clairbee/rebot-devarm/hardware/reBot_B601_RS/gripper.md

# gripper

The B601 RS gripper as the released assembly holds it (22 of its 23 components; 2-M7-STATOR.step is not published)

Package: `//pub/robotics/rebot/devarm/b601-rs`

gripper

## Parts

### [//pub/robotics/rebot/devarm/b601-rs](README.md)

| Part |  | Count | Material | Method | Process | Tolerance | Vendor | SKU | File | Description |
| --- | --- | ---: | --- | --- | --- | ---: | --- | --- | --- | --- |
| actuator-rs00 | actuator-rs00 | 1 | aluminium alloy |  |  |  | seeedstudio | [Robostride-00-Actuator-p-6664](https://www.seeedstudio.com/Robostride-00-Actuator-p-6664.html) | `vendor/actuator-rs00.step` | Brushless actuator RobStride RS00 (x4) |
| carriage-mgn9 | carriage-mgn9 | 2 | stainless steel |  |  |  | amazon | B0D9QBQDKB | `vendor/carriage-mgn9c.step` | Slider block MGN9 (x2, gripper) |
| connector-xt30 | connector-xt30 | 2 | nylon |  |  |  |  |  | `vendor/connector-xt30-2x2.step` | XT30 2+2 connector body, the motor end of a harness (x12 in the released CAD) |
| finger | finger | 2 | ABS | additive |  | ±0.2 mm |  |  | `3D_Printed_Parts/1-CLIP.step` | Gripper finger (x2) - print from the side of the gripper for strength; 0.4 mm nozzle, 0.2 mm layer height, 45% infill |
| gear-connector | gear-connector | 1 | AL 5052 | subtractive | Anodized or sandblasted, H7 or interference fit on mating features | ±0.02 mm |  |  | `Metal_Parts/02_Gear_Connector.step` | The boss the gripper pinion sits on (x1) - RS copy: 2-M7-ROTOR.step, which README.md calls 2-M7-STATOR.step and lists as "gripper connector B" |
| gear-m1-16t | gear-m1-16t | 1 | steel |  |  |  | amazon | B0GDSR1LKM | `vendor/gear-m1-16t-b6.step` | Module 1, 16 tooth, 6 mm bore gear - what drives the two gripper racks (x1) |
| gripper-connector-a | gripper-connector-a | 1 | AL 5052 | subtractive | Anodized or sandblasted, H7 or interference fit on mating features | ±0.02 mm |  |  | `Metal_Parts/02_Gripper_Connector_A.step` | Gripper connector A (x1) - RS copy: 2-M6-ROTOR.step |
| motor-cable-clip | motor-cable-clip | 1 | AL 5052 | subtractive | Anodized or sandblasted, H7 or interference fit on mating features | ±0.02 mm |  |  | `Metal_Parts/1-O-CLIP.step` | Motor 4-7 cable fixing (x4) - can be printed in ABS with M2 nuts instead |
| pad-silicone | pad-silicone | 4 | silicone |  |  |  | amazon | B0F9KVYXFZ | `vendor/pad-silicone-30x9x2.step` | Silicone pad 30x9x2mm (x1 per the readme; the released CAD has four) |
| rack | rack | 2 | AL 5052 | subtractive | Anodized or sandblasted, H7 or interference fit on mating features | ±0.02 mm |  |  | `Metal_Parts/02_Rack.step` | Rack (x2) - RS copy: 2-RACK-1M.step |
| rail-bracket | rail-bracket | 1 | PLA | additive |  | ±0.2 mm |  |  | `3D_Printed_Parts/01_Rail_Bracket.step` | Gripper slider support bracket (x1) - RS copy: 1-RAIL-BASE-2.step |
| rail-mgn9-170 | rail-mgn9-170 | 1 | stainless steel |  |  |  | amazon | B0D54L45WM | `vendor/rail-mgn9-170.step` | Linear rail MGN9-170mm (x1, gripper) |
| slider-bracket | slider-bracket | 1 | AL 5052 | subtractive | Anodized or sandblasted, H7 or interference fit on mating features | ±0.02 mm |  |  | `Metal_Parts/02_Slider_Bracket.step` | Gripper slider metal bracket (x1) - RS copy: 2-RAIL-BASE-1.step |
| slider-extension | slider-extension | 2 | AL 5052 | subtractive | Anodized or sandblasted, H7 or interference fit on mating features | ±0.02 mm |  |  | `Metal_Parts/02_Slider_Extension.step` | Slider to gripper extension (x2) - RS copy: 2-SLIDER-FIX.step |

## Stock

What the manufactured parts are made from: one piece for each part made from it.

### [//pub/robotics/rebot/devarm/b601-rs](README.md)

| Stock | Count | For | Description |
| --- | ---: | --- | --- |
| gear-connector-blank | 1 | gear-connector |  |
| gripper-connector-a-blank | 1 | gripper-connector-a | The 5052 plate gripper-connector-a is cut from |
| motor-cable-clip-blank | 1 | motor-cable-clip | The 5052 plate motor-cable-clip is cut from |
| rack-blank | 2 | rack | The 5052 plate rack is cut from |
| slider-bracket-blank | 1 | slider-bracket | The 5052 plate slider-bracket is cut from |
| slider-extension-blank | 2 | slider-extension | The 5052 plate slider-extension is cut from |

<br/><br/>

*Generated by [PartCAD](https://partcad.org/)*
