clairbee/rebot-devarm/hardware/reBot_B601_DM/gripper.md

# gripper

The B601 DM gripper as the released assembly holds it (49 components)

Package: `//pub/robotics/rebot/devarm/b601-dm`

gripper

## Parts

### [//pub/robotics/rebot/devarm/b601-dm](README.md)

| Part |  | Count | Material | Method | Process | Tolerance | Vendor | SKU | File | Description |
| --- | --- | ---: | --- | --- | --- | ---: | --- | --- | --- | --- |
| carriage-mgn9 | carriage-mgn9 | 2 | stainless steel |  |  |  | amazon | B0D9QBQDKB | `vendor/carriage-mgn9c.step` | Slider block MGN9 (x2, gripper) |
| finger | finger | 2 | ABS | additive |  | ±0.2 mm |  |  | `3D_Printed_Parts/01_Finger.step` | Gripper finger (x2); 0.4 mm nozzle, 0.2 mm layer height, 45% infill |
| gear-connector | gear-connector | 1 | AL 5052 | subtractive | Anodized or sandblasted, H7 or interference fit on mating features | ±0.02 mm |  |  | `Metal_Parts/02_Gear_Connector.step` | Gear connector (x1) |
| gear-m1-16t | gear-m1-16t | 1 | steel |  |  |  | amazon | B0GDSR1LKM | `vendor/gear-m1-16t-b6.step` | Module 1, 16 tooth, 6 mm bore gear - what drives the two gripper racks (x1) |
| rack | rack | 2 | AL 5052 | subtractive | Anodized or sandblasted, H7 or interference fit on mating features | ±0.02 mm |  |  | `Metal_Parts/02_Rack.step` | Rack (x2) |
| rail-bracket | rail-bracket | 1 | PLA | additive |  | ±0.2 mm |  |  | `3D_Printed_Parts/01_Rail_Bracket.step` | Gripper slider support bracket (x1); 0.4 mm nozzle, 0.2 mm layer height, 15% infill |
| rail-mgn9-170 | rail-mgn9-170 | 1 | stainless steel |  |  |  | amazon | B0D54L45WM | `vendor/rail-mgn9-170.step` | Linear rail MGN9-170mm (x1, gripper) |
| screw-hm3-25 | screw-hm3-25 | 6 | stainless steel |  |  |  | amazon | B0DJQFGRPQ (120 per pack) | `vendor/screw-hm3x25.step` | M3x25 hex socket head cap screw (x14+) |
| screw-hm3-6 | screw-hm3-6 | 4 | stainless steel |  |  |  | amazon | B0DJQG5YLF (120 per pack) | `vendor/screw-hm3x6.step` | M3x6 hex socket head cap screw (x16+) |
| screw-ka3-12 | screw-ka3-12 | 4 | steel |  |  |  | amazon | B01MXSS95N (100 per pack) | `vendor/screw-ka3x12.step` | KA3x12 self-tapping screw (x60; README.md says 72+) |
| screw-km3-16 | screw-km3-16 | 8 | stainless steel |  |  |  | amazon | B01E6EIC2S | `vendor/screw-km3x16.step` | M3x16 countersunk head screw (x34+) |
| screw-km3-7 | screw-km3-7 | 12 | stainless steel |  |  |  | amazon | B01E6EIC2S | `vendor/screw-km3x7.step` | M3x7 countersunk head screw (x76+) |
| screw-m4x5-set | screw-m4x5-set | 2 | steel |  |  |  |  |  | `vendor/screw-m4x5-set.step` | M4x5 set screw (x2); the released CAD calls it S-M4-5-JIMI and README.md does not list it |
| slider-bracket | slider-bracket | 1 | AL 5052 | subtractive | Anodized or sandblasted, H7 or interference fit on mating features | ±0.02 mm |  |  | `Metal_Parts/02_Slider_Bracket.step` | Gripper slider metal bracket (x1) - printable in ABS at high infill, not for long-term use |
| slider-extension | slider-extension | 2 | AL 5052 | subtractive | Anodized or sandblasted, H7 or interference fit on mating features | ±0.02 mm |  |  | `Metal_Parts/02_Slider_Extension.step` | Slider to gripper extension (x2) |

## Stock

What the manufactured parts are made from: one piece for each part made from it.

### [//pub/robotics/rebot/devarm/b601-dm](README.md)

| Stock | Count | For | Description |
| --- | ---: | --- | --- |
| gear-connector-blank | 1 | gear-connector | The 5052 plate gear-connector is cut from |
| rack-blank | 2 | rack | The 5052 plate rack is cut from |
| slider-bracket-blank | 1 | slider-bracket | The 5052 plate slider-bracket is cut from |
| slider-extension-blank | 2 | slider-extension | The 5052 plate slider-extension is cut from |

<br/><br/>

*Generated by [PartCAD](https://partcad.org/)*
