clairbee/rebot-devarm/hardware/reBot_B601_DM/power-supply.md

# power-supply

Power supply enclosure, assembled per README.md "Power Supply Assembly"

Package: `//pub/robotics/rebot/devarm/b601-dm`

power-supply

## Parts

### [//pub/robotics/rebot/devarm/b601-dm](README.md)

| Part |  | Count | Material | Method | Tolerance | Vendor | SKU | File | Description |
| --- | --- | ---: | --- | --- | ---: | --- | --- | --- | --- |
| connector-xt60e | connector-xt60e | 1 | nylon |  |  | amazon | B0CQK1P1DP | `src/connector_xt60e.py` | Output port XT60E female + lug pigtail (x1) |
| psu-front-cover | psu-front-cover | 1 | PLA | additive | ±0.2 mm |  |  | `3D_Printed_Parts/DM-power-Top Cover.stp` | Power supply front cover (x1); 0.4 mm nozzle, 0.2 mm layer height, 30% infill |
| psu-front-cover-slider | psu-front-cover-slider | 1 | PLA | additive | ±0.2 mm |  |  | `3D_Printed_Parts/DM-power-Top Cover-Sliding Cover.stp` | Power supply front cover slider (x1); 0.4 mm nozzle, 0.2 mm layer height, 30% infill |
| psu-lrs-350-24 | psu-lrs-350-24 | 1 | galvanized steel |  |  | amazon | B013ETVO12 | `src/psu_enclosed.py` | Power supply MeanWell LRS-350-24, 24V 14.6A (x1) |
| psu-rear-cover | psu-rear-cover | 1 | PLA | additive | ±0.2 mm |  |  | `3D_Printed_Parts/DM-power-Bottom Cover.stp` | Power supply rear cover (x1); 0.4 mm nozzle, 0.2 mm layer height, 30% infill |
| screw-m3x8-countersunk | screw-m3x8-countersunk | 2 |  |  |  |  |  |  | M3x8 304 stainless steel Phillips countersunk head screw (x2) |
| screw-m3x8-pan | screw-m3x8-pan | 2 |  |  |  |  |  |  | M3x8 304 stainless steel Phillips pan head screw (x2) |
| screw-m4x6-countersunk | screw-m4x6-countersunk | 6 |  |  |  |  |  |  | M4x6 304 stainless steel Phillips countersunk head screw (x6) |

<br/><br/>

*Generated by [PartCAD](https://partcad.org/)*
