clairbee/rebot-devarm/hardware/reBot_B601_DM/doc/buying.md

# Buying the parts of the reBot Arm B601 DM

*What* to buy and *how many* is [the generated parts list](../arm.md), and the
power supply's is [power-supply.md](../power-supply.md): every bought part there
carries its vendor and the exact SKU, and each one has a shape, so it is in the
model for fit and collision checking as well as in the list.

This document is what a generated parts list cannot carry: a reference price and
a link to the offer. The prices are also in
[../../../providers/price_list.csv](../../../providers/price_list.csv), which is
what `pc supply quote` reads - the readme's own figures, in the one place a price
belongs, so that a quote for the whole arm is a command rather than an addition
sum. Prices go stale the way any hand-written table does; treat them as an order
of magnitude.

## Standard parts

> [!WARNING]
> Since everyone will need to assemble and tighten the screws themselves, standard hex socket screws have been selected. After prolonged operation, the screws may loosen, which will affect the precision of the robotic arm. For this reason, you are required to purchase additional hot melt glue to perform thread locking on the screws at each joint.

If you have a power drill or similar tools, you may choose to buy lock washers or thread-locking screws instead. However, **it is extremely important** that you use the lowest torque setting when using an electric screwdriver to avoid thread stripping, which will result in irreversible damage.

  | Name | Specification / Model | Quantity | Reference Price | Notes |
  |------|----------|------|----------|------|
  | Brushless motor | DM4310(V4) | 4 | 120 $/unit | [SeeedStudio](https://www.seeedstudio.com/DIP-Servo-Motor-24V-120RPM-Brushless-98-9mm-4P-L56-W56-H46mm-p-6660.html) |
  | Brushless motor | DM4340P(V4) | 3 | 175 $/unit |  [SeeedStudio](https://www.seeedstudio.com/DM4340P-Actuator-p-6663.html)  |
  | CAN-USB driver board |  | 1 | 15 $/unit |   [SeeedStudio](https://www.seeedstudio.com/DM-CAN-USB-Driver-Borad-p-6706.html)   |
  | Bearing | 6707ZZ | 1 | 13 $/unit | [Amazong](https://www.amazon.com/uxcell-35x44x5mm-Shielded-Precision-Lubricated/dp/B0D6WBMW3F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) |
  | Bearing | 6803ZZ | 3 | 13 $/unit | [Amazong](https://www.amazon.com/uxcell-17x26x5mm-Shielded-Precision-Lubricated/dp/B0D54JSWBZ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) |
  | Bearing | AXK5578 | 1 | 12 $/unit | [Amazong](https://www.amazon.com/PZRT-AXK5578-Thrust-Bearings-Washers/dp/B0B3M3RZGW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) |
  | Linear rail | MGN9-170mm | 1 | 23 $/unit | [Amazong](https://www.amazon.com/uxcell-Sliding-Carriage-Bearing-Printers/dp/B0D54L45WM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) |
  | Slider block | MGN9 | 2 | 10 $/unit | [Amazong](https://www.amazon.com/uxcell-Bearing-Sliding-Carriage-Anti-Fall/dp/B0D9QBQDKB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) |
  | Gear | Module 1, boss type, 16 teeth, 6 mm bore | 1 | 44$/unit | [Amazong](https://www.amazon.com/Module-15-Teeth-Finished-Perforation/dp/B0GDSR1LKM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)  |
  | Silicone pad | 30x9x2mm | 1 | 10 $ | [Amazong](https://www.amazon.com/Self-Adhesive-Anti-Sliding-Anti-Scratch-Protectors-Appliances/dp/B0F9KVYXFZ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) |
  | Screw | HM3-12mm screw | 14+ |  | [Amazong](https://www.amazon.com/BNUOK-120pcs-Stainless-Threads-Spanner/dp/B0DJQGMQZM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) |
  | Screw | HM3-25mm screw | 14+ |  | [Amazong](https://www.amazon.com/BNUOK-120pcs-Stainless-Threads-Spanner/dp/B0DJQFGRPQ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)  |
  | Screw | HM3-6mm screw | 16+ |  | [Amazong](https://www.amazon.com/BNUOK-120pcs-Stainless-Threads-Spanner/dp/B0DJQG5YLF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)  |
  | Screw | HM4-75mm set screw | 4+ |  | [Amazong](https://www.amazon.com/iexcell-Partially-Threaded-Thread-Socket/dp/B0DR1NX178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)  |
  | Screw | KM3*12mm screw | 30+ |  |  [Amazong](https://www.amazon.com/Uxcell-a16011300ux0872-M3x12mm-Carbon-Countersunk/dp/B01E6EIC2S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) |
  | Screw | KM3*16mm screw | 34+ |  | [Amazong](https://www.amazon.com/Uxcell-a16011300ux0872-M3x12mm-Carbon-Countersunk/dp/B01E6EIC2S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)  |
  | Screw | KM3*7mm screw | 76+ |  |[Amazong](https://www.amazon.com/Uxcell-a16011300ux0872-M3x12mm-Carbon-Countersunk/dp/B01E6EIC2S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)   |
  | Screw | KM3*9mm screw | 31+ |  |[Amazong](https://www.amazon.com/Uxcell-a16011300ux0872-M3x12mm-Carbon-Countersunk/dp/B01E6EIC2S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)   |
  | Screw | KM3*8mm Socket Micro Profile Head Screw | 31+ |  |[Amazong](https://www.amazon.com/SMALLRIG-Screw-Screws-12pcs-Pack/dp/B01MS60KSY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)   |
  | Screw | KA3*12mm | 72+ |  | [Amazong](https://www.amazon.com/uxcell-Phillips-Tapping-Screws-Silver/dp/B01MXSS95N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)  |
  | Dowel pin | M4*8mm | Several |  | [Amazong](amazon.com/HARFINGTON-Stainless-Cylindrical-Furniture-Installation/dp/B0F6CWL4MP/ref=sr_1_6?crid=2BZ4J412S4QSB&dib=eyJ2IjoiMSJ9.a3kVMi6W355gYKjK1Sl_QFVcJD8x7DTXqxgk66DoY4TnPOEV9TG7AbW7jkNk2USTJrqrb3e5Ve0EeVwHVE-_s-UUP6jFahdiVAqkZGGnuBpVxwA-MCHYQEwThEfygwAc1HVyN1n7Cvr8GAFMvs5AfciRrbUZ8AsSNGc1Obgf8qouOe8NQhyW_Zo7YINX1m3YCuTRiLZCvB6o7XlZtZ4PRh085Bva6AjjnlNOuaiPCtzjvNUtTpyLpGmqoHM165V6onFghMcuOX9RaacnxQNsRoUtKpWPEB8h48nUnUOJ1lg.Hfy_mUj7QFR_kILC4I5RNy6h7HmdswULHg3NmKmK8bU&dib_tag=se&keywords=Dowel%2Bpin%2BM4*7&qid=1776331648&s=industrial&sprefix=dowel%2Bpin%2Bm4%2B%2Cindustrial%2C399&sr=1-6&th=1)  |
  | Dowel pin | M4*12mm | Several |  | [Amazong](amazon.com/HARFINGTON-Stainless-Cylindrical-Furniture-Installation/dp/B0F6CWL4MP/ref=sr_1_6?crid=2BZ4J412S4QSB&dib=eyJ2IjoiMSJ9.a3kVMi6W355gYKjK1Sl_QFVcJD8x7DTXqxgk66DoY4TnPOEV9TG7AbW7jkNk2USTJrqrb3e5Ve0EeVwHVE-_s-UUP6jFahdiVAqkZGGnuBpVxwA-MCHYQEwThEfygwAc1HVyN1n7Cvr8GAFMvs5AfciRrbUZ8AsSNGc1Obgf8qouOe8NQhyW_Zo7YINX1m3YCuTRiLZCvB6o7XlZtZ4PRh085Bva6AjjnlNOuaiPCtzjvNUtTpyLpGmqoHM165V6onFghMcuOX9RaacnxQNsRoUtKpWPEB8h48nUnUOJ1lg.Hfy_mUj7QFR_kILC4I5RNy6h7HmdswULHg3NmKmK8bU&dib_tag=se&keywords=Dowel%2Bpin%2BM4*7&qid=1776331648&s=industrial&sprefix=dowel%2Bpin%2Bm4%2B%2Cindustrial%2C399&sr=1-6&th=1)  |
  | Screwdriver set | Hex key set | 1 | 16$  | [Amazong](amazon.com/Amazon-Basics-Ratcheting-Electronics-Screwdriver/dp/B07V4TFWFZ/ref=sr_1_2?crid=ADAY70RZDSLN&dib=eyJ2IjoiMSJ9.jcLL4o6IXTnPlPfTTzbCZCBuZx2sLkvdUQCwlL58aq__GOyLxVPnwLI0mvGptba_HeVz6ctLQ_ziQw56BMDH9IOaw-4PVJGMktQM74mWficwggm3ckDGyAH-agN_zkB3K0_W-wrS56jfcMYFbZSWhWxr-iSOC4sdXwMGlt4rYGtenyn9yAFYBIHqjU2El5_OAKuspsrF0yQvfyfQPQHs46SClWN8zlSemGVZRuVSU26f0f9yApF6BfWHANKNNhT0Mfb6bQ8oM2XUMvwaazrrKoHeTARuoflVaVZvMU776bs.r8gy_gMINEy0qy4JyK--z-IbPZEv-SWeMGohOOE7M60&dib_tag=se&keywords=Screwdriver+set&qid=1774772499&s=industrial&sprefix=screwdriver+set+%2Cindustrial%2C374&sr=1-2)  |
  |  | XT30 2+2 350mm | 2 | 4 $/cable | Both ends angled |
  |  | XT30 2+2 350mm | 1 | 4 $/cable | One angled end and one straight end |
  |  | XT30 2+2 200mm | 3 | 4 $/cable | Both ends angled |
  |  | XT30 2+2 200mm | 1 | 3 $/cable | Both ends straight |

### About Fixing
You may modify your base freely based on the 3D printed parts we provide. You can also use G-clamps according to the thickness of your desktop.

  | Name | Specification / Model | Quantity | Reference Price | Notes |
  |------|----------|------|----------|------|
  | Woodworking clamp | 6-inch G clamp | 2 | 20 $/unit | [Amazong](https://www.amazon.com/gp/aw/d/B092J1YW2M/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) |

### About Power Supply
The robotic arm is shipped without a power supply by default. You may connect your own battery, or purchase a reliable 24V 14.6A MeanWell power supply made in Taiwan. Additionally, you will need to buy a three-pin plug compliant with local standards and a wiring harness with XT30 female connector.

#### Consumables BOM

| Name | Specification | Qty | Reference Price | Notes | Image |
|:---|:---|:---:|:---:|:---|:---:|
| Power Supply | LRS-350-24 (24V 14.6A) | 1 | $27.35 | [amazon](https://www.amazon.com/MEAN-WELL-LRS-350-24-350-4W-Switchable/dp/B013ETVO12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) |  |
| Power Cord | US Standard AC Cable | 1 | $4.49 | [amazon](https://www.amazon.com/LIFEPOE-Power-3-3ft-Black-3-Prong/dp/B0FK4KPW2G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) |  |
| Output Port | XT60E Fixed Female Connector; XT60E Female + Lug - 10cm; 4mm Lug Hole | 1 | $9.99 | [amazon](https://www.amazon.com/LINSYRC-XT60E-F-Connector-Battery-Quadcopter/dp/B0CQK1P1DP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) |  |
| Power AC Wiring | 1.5mm²; Red, Blue, Yellow x1 each(User must crimp terminals to the wire — pre-crimped leads not included.); 10CM | 3 | $0.99 | [aliexpress](https://www.aliexpress.com/item/1005008648016252.html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) |  |
| 3-in-1 IEC Inlet Socket | Quick-connect type with red switch (Dual Nuts) | 1 | $1.98 | [aliexpress](https://www.aliexpress.com/item/1005005962021242.html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) |  |
| XT30 to XT60 adapter cable plug | XT30U female to XT60 male | 1 | 8.99$ | [amazon](https://www.amazon.com/dp/B0BY8PSHK6?th=1) |  |
| 304 Stainless Steel Phillips Countersunk Head Screw | M4x6 | 6 | $0.37 | / | / |
| 304 Stainless Steel Phillips Countersunk Head Screw | M3x8 | 2 | $0.36 | / | / |
| 304 Stainless Steel Phillips Pan Head Screw | M3x8 | 2 | $0.32 | / | / |
| Hex Nut | M3x2.5 | 2 | 2.10 CNY | / | / |

#### Printed Parts BOM

The three printed shells are the `psu-*` lines of
[power-supply.md](../power-supply.md), with their material and print settings.
