clairbee/rebot-devarm/hardware/reBot_B601_RS/doc/buying.md

# Buying the parts of the reBot Arm B601 RS

*What* to buy and *how many* is [the generated parts list](../arm.md), and the
power supply's is [power-supply.md](../power-supply.md): every bought part there
carries its vendor and the exact SKU, and each one has a shape.

This document is what a generated parts list cannot carry: a reference price and
a link to the offer. The prices are also in
[../../../providers/price_list.csv](../../../providers/price_list.csv), which is
what `pc supply quote` reads. Prices go stale the way any hand-written table
does; treat them as an order of magnitude.

## Standard parts

> [!WARNING]
> Since everyone will need to assemble and tighten the screws themselves, standard hex socket screws have been selected. After prolonged operation, the screws may loosen, which will affect the precision of the robotic arm. For this reason, you are required to purchase additional hot melt glue to perform thread locking on the screws at each joint.

If you have a power drill or similar tools, you may choose to buy lock washers or thread-locking screws instead. However, **it is extremely important** that you use the lowest torque setting when using an electric screwdriver to avoid thread stripping, which will result in irreversible damage.

  | Name | Specification / Model | Quantity | Reference Price | Notes |
  |------|----------|------|----------|------|
  | Brushless motor | RobStride RS00 | 4 | 125 $/unit | [SeeedStudio](https://www.seeedstudio.com/Robostride-00-Actuator-p-6664.html) |
  | Brushless motor | RobStride RS06 | 3 | 210 $/unit |  [SeeedStudio](https://www.seeedstudio.com/Robostride-06-Actuator-p-6668.html)  |
  | CAN-USB driver board |  | 1 | 15 $/unit |   [SeeedStudio](https://www.amazon.com/Xiusiyt-Converter-Preloaded-PCAN-Firmware/dp/B0GBW7RTXD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)   |
  | XT30 2+2 Power Separation Borrd |  | 1 | 15 $/unit |   [SeeedStudio](https://www.seeedstudio.com/XT30-2-2-Power-Separation-Board-p-6707.html)   |
  | Bearing | 6803ZZ | 3 | 13 $/unit | [Amazong](https://www.amazon.com/uxcell-17x26x5mm-Shielded-Precision-Lubricated/dp/B0D54JSWBZ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) |
  | Bearing | AXK5578 | 1 | 12 $/unit | [Amazong](https://www.amazon.com/PZRT-AXK5578-Thrust-Bearings-Washers/dp/B0B3M3RZGW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) |
  | Linear rail | MGN9-170mm | 1 | 23 $/unit | [Amazong](https://www.amazon.com/uxcell-Sliding-Carriage-Bearing-Printers/dp/B0D54L45WM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) |
  | Slider block | MGN9 | 2 | 10 $/unit | [Amazong](https://www.amazon.com/uxcell-Bearing-Sliding-Carriage-Anti-Fall/dp/B0D9QBQDKB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) |
  | Gear | Module 1, boss type, 16 teeth, 6 mm bore | 1 | 44$/unit | [Amazong](https://www.amazon.com/Module-15-Teeth-Finished-Perforation/dp/B0GDSR1LKM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)  |
  | Silicone pad | 30x9x2mm | 1 | 10 $ | [Amazong](https://www.amazon.com/Self-Adhesive-Anti-Sliding-Anti-Scratch-Protectors-Appliances/dp/B0F9KVYXFZ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) |
  | Screw | KM3*7mm screw | 80+ |  |[Amazong](https://www.amazon.com/Uxcell-a16011300ux0872-M3x12mm-Carbon-Countersunk/dp/B01E6EIC2S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)   |
  | Screw | KM3*16mm screw | 8+ |  |[Amazong](https://www.amazon.com/Uxcell-a16011300ux0872-M3x12mm-Carbon-Countersunk/dp/B01E6EIC2S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)   |
  | Screw | KA3*12mm | 48+ |  | [Amazong](https://www.amazon.com/uxcell-Phillips-Tapping-Screws-Silver/dp/B01MXSS95N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)  |
  | Screw | HM3-8mm screw | 60+ |  | [Amazong](https://www.amazon.com/BNUOK-120pcs-Stainless-Threads-Spanner/dp/B0DJQG5YLF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)  |
  | Screw | HM3-30mm screw | 16+ |  | [Amazong](https://www.amazon.com/BNUOK-120pcs-Stainless-Threads-Spanner/dp/B0DJQFGRPQ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) 
  | Screw | HM4-8mm set screw | 6+ |  | [Amazong](https://www.amazon.com/iexcell-Partially-Threaded-Thread-Socket/dp/B0DR1NX178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)  |
  | Screw | HM4-16mm set screw | 18+ |  | [Amazong](https://www.amazon.com/iexcell-Partially-Threaded-Thread-Socket/dp/B0DR1NX178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)  |
  | Screw | HM4-70mm set screw | 4+ |  | [Amazong](https://www.amazon.com/iexcell-Partially-Threaded-Thread-Socket/dp/B0DR1NX178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)  |
 | Screw | HM3-6mm screw | 8+ |  | [Amazong](https://www.amazon.com/BNUOK-120pcs-Stainless-Threads-Spanner/dp/B0DJQG5YLF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)  |
 | Screw | HM3-26mm screw | 6+ |  | [Amazong](https://www.amazon.com/BNUOK-120pcs-Stainless-Threads-Spanner/dp/B0DJQG5YLF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)  |
 | XT30 2+2 Cable | Two Side Elbows 320mm | 1+ |   | This will require custom fabrication on your end.  |
 | XT30 2+2 Cable | Two Side Elbows 200mm | 4+ |   | This will require custom fabrication on your end.  |
 | XT30 2+2 Cable | One Side Elbow 300mm| 1+ |   |  This will require custom fabrication on your end. |
 | XT30 2+2 Cable | Two Side Straight | 1+ |  |   |
  | Screwdriver set | Hex key set | 1 | 16$  | [Amazong](amazon.com/Amazon-Basics-Ratcheting-Electronics-Screwdriver/dp/B07V4TFWFZ/ref=sr_1_2?crid=ADAY70RZDSLN&dib=eyJ2IjoiMSJ9.jcLL4o6IXTnPlPfTTzbCZCBuZx2sLkvdUQCwlL58aq__GOyLxVPnwLI0mvGptba_HeVz6ctLQ_ziQw56BMDH9IOaw-4PVJGMktQM74mWficwggm3ckDGyAH-agN_zkB3K0_W-wrS56jfcMYFbZSWhWxr-iSOC4sdXwMGlt4rYGtenyn9yAFYBIHqjU2El5_OAKuspsrF0yQvfyfQPQHs46SClWN8zlSemGVZRuVSU26f0f9yApF6BfWHANKNNhT0Mfb6bQ8oM2XUMvwaazrrKoHeTARuoflVaVZvMU776bs.r8gy_gMINEy0qy4JyK--z-IbPZEv-SWeMGohOOE7M60&dib_tag=se&keywords=Screwdriver+set&qid=1774772499&s=industrial&sprefix=screwdriver+set+%2Cindustrial%2C374&sr=1-2)  |

### About Fixing
You may modify your base freely based on the 3D printed parts we provide. You can also use G-clamps according to the thickness of your desktop.

  | Name | Specification / Model | Quantity | Reference Price | Notes |
  |------|----------|------|----------|------|
  | Woodworking clamp | 6-inch G clamp | 2 | 20 $/unit | [Amazong](https://www.amazon.com/gp/aw/d/B092J1YW2M/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) |

### About Power Supply
The robotic arm is shipped without a power supply by default. You may connect your own battery, or purchase a reliable 48V 12.5A MeanWell power supply made in Taiwan. Additionally, you will need to buy a three-pin plug compliant with local standards and a wiring harness with XT30 female connector.

#### Consumables BOM

| Name | Specification | Qty | Reference Price | Notes | Image |
|:---|:---|:---:|:---:|:---|:---:|
| Power Supply | LRS-600-48（48V12.5A） | 1 | $69.5 | [amazon](https://www.amazon.com/LRS-600-48-Switching-Upgrade-Version-SE-600-48/dp/B0BV5XFYNS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) |  |
| Power Cord | US Standard AC Cable | 1 | $4.49 | [amazon](https://www.amazon.com/LIFEPOE-Power-3-3ft-Black-3-Prong/dp/B0FK4KPW2G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) |  |
| Output Port | XT60E Fixed Female Connector; XT60E Female + Lug - 10cm; 4mm Lug Hole | 1 | $9.99 | [amazon](https://www.amazon.com/LINSYRC-XT60E-F-Connector-Battery-Quadcopter/dp/B0CQK1P1DP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) |  |
| Power AC Wiring | 1.5mm²; Red, Blue, Yellow x1 each(User must crimp terminals to the wire — pre-crimped leads not included.); 10CM | 3 | $0.99 | [aliexpress](https://www.aliexpress.com/item/1005008648016252.html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) |  |
| 3-in-1 IEC Inlet Socket | Quick-connect type with red switch (Dual Nuts) | 1 | $1.98 | [aliexpress](https://www.aliexpress.com/item/1005005962021242.html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) |  |
| XT30 to XT60 adapter cable plug | XT30U female to XT60 male | 1 | 8.99$ | [amazon](https://www.amazon.com/dp/B0BY8PSHK6?th=1) |  |
| 304 Stainless Steel Phillips Countersunk Head Screw | M4x6 | 10 | $0.37 | / | / |
| 304 Stainless Steel Phillips Countersunk Head Screw | M3x8 | 2 | $0.36 | / | / |
| 304 Stainless Steel Phillips Pan Head Screw | M3x8 | 2 | $0.32 | / | / |
| Hex Nut | M3x2.5 | 2 | 2.10 CNY | / | / |

Printed Parts BOM: the three printed shells are the `psu-*` lines of
[power-supply.md](../power-supply.md), with their material and print settings.
