clairbee/rebot-devarm/hardware/reBot_B601_DM/doc/power-supply-assembly.md

# Assembling the power supply enclosure

The parts are [power-supply.md](../power-supply.md), generated from
[power-supply.assy](../power-supply.assy). These are the steps, as the vendor
published them.

They are still a document rather than data: each step's words belong on the
matching node of the ASSY file (its `description:`), and its photograph has
nowhere to go there at all - see [PARTCAD.md](../../../PARTCAD.md). Until that is
true, this is where they live.

#### Power Supply Assembly

The power supply assembly is divided into two main sections: the Front Cover and the Rear Cover.

##### 1. Front Cover Assembly

| Step | Operation Instructions | Image | Remarks |
|:---:|---|---|---|
| 1-1 | Prepare the parts and printed components required for front shell assembly |  | Check that all parts are complete |
| 1-2 | Wiring sequence instructions for each part; assemble according to the wiring sequence | <br> | Connect strictly according to the wiring sequence |
| 1-3 | Install the XT60 connector |  | Secure with 304 stainless steel Phillips countersunk head screws M3x8 and hex nuts M3x2.5 |
| 1-4 | Install the 3-in-1 IEC socket |  | Secure the 3-in-1 IEC socket with 304 stainless steel Phillips pan head screws M3x8 |
| 1-5 | Internal wiring of the front shell | <br> | Check connections against the wiring sequence diagram |
| 1-6 | Secure both sides of the front shell and the power supply |  | M4x6 304 stainless steel Phillips countersunk head screws x2 |
| 1-7 | Install the sliding cover |  | Push in from the bottom of the power supply |
| 1-8 | Secure the sliding cover |  | M4x6 304 stainless steel Phillips countersunk head screws x2 |

---

##### 2. Rear Shell Assembly

| Step | Operation Instructions | Image | Remarks |
|:---:|---|---|---|
| 2-1 | Prepare the parts and printed components required for rear shell assembly |  | Check accessories for completeness |
| 2-2 | Assemble the rear shell with the power supply |  | Align the position |
| 2-3 | Secure both sides of the rear shell and the power supply |  | M4x6 304 stainless steel Phillips countersunk head screws x2 |

---

##### 3. Overall Completion

| Step | Operation Instructions | Image | Remarks |
|:---:|---|---|---|
| 1 | Power supply solution assembly completed |  | Check that all screws are tightened |

---
