clairbee/rebot-devarm/hardware/reBot_B601_RS/doc/power-supply-assembly.md

# Assembling the power supply enclosure

The parts are [power-supply.md](../power-supply.md), generated from
[power-supply.assy](../power-supply.assy). These are the steps, as the vendor
published them - and still a document rather than data: see
[PARTCAD.md](../../../PARTCAD.md).

#### Power Supply Assembly

- The power supply assembly steps are divided into two parts: front shell and rear shell:

##### 1. Front Shell Assembly

| Step | Description | Image | Notes |
|:---:|---|---|---|
| 1-1 | Prepare the parts and printed components required for front shell assembly |  | Check that all parts are present |
| 1-2 | Wiring sequence instructions for each part; assemble according to the wiring sequence | <br> | Connect strictly according to the wiring sequence |
| 1-3 | Install the XT60 connector |  | Secure with M3x8 304 countersunk cross-head screws and M3x2.5 hex nuts |
| 1-4 | Install the 3-in-1 IEC socket |  | Secure the 3-in-1 IEC socket with M3x8 304 pan head cross-head screws |
| 1-5 | Internal wiring of the front shell | <br> | Check connections against the wiring diagram |
| 1-6 | Secure the front shell to both sides of the power supply |  | 4x M4x6 304 countersunk cross-head screws |
| 1-7 | Install the sliding cover |  | Push in from the bottom of the power supply |
| 1-8 | Secure the sliding cover |  | 2x M4x6 304 countersunk cross-head screws |

---

##### 2. Rear Shell Assembly

| Step | Description | Image | Notes |
|:---:|---|---|---|
| 2-1 | Prepare the parts and printed components required for rear shell assembly |  | Check that all accessories are complete |
| 2-2 | Assemble the rear shell with the power supply |  | Align the position |
| 2-3 | Secure the rear shell to both sides of the power supply |  | 4x M4x6 304 countersunk cross-head screws |

---

##### 3. Final Completion

| Step | Description | Image | Notes |
|:---:|---|---|---|
| 1 | Power supply assembly completed |  | Check that all screws are tightened |

---
