clairbee/rebot-devarm/hardware/reBot_B601_RS/partcad.yaml

# Every part of the reBot Arm B601 RS (RobStride RS00/RS06 actuators).
#
# Same conventions as the DM variant - see ../reBot_B601_DM/partcad.yaml and
# ../../PARTCAD.md. ./README.md is generated from this file, and so are ./arm.md
# and ./power-supply.md; quantities live in ./arm.assy, and the "(xN)" suffix in
# each 'desc' keeps the readme quantity until the assemblies carry real
# placements.
#
# Seven of this arm's parts are the DM arm's parts: the same geometry, published
# by the vendor under a different file name. Each of those is an alias of the DM
# declaration rather than a second copy of it - see the "Shared with the DM arm"
# section below.

desc: reBot Arm B601 RS - RobStride RS00/RS06 actuators
url: https://github.com/clairbee/rebot-devarm/tree/main/hardware/reBot_B601_RS
manufacturable: true

# What ./README.md says above the generated parts list. The folder is a PartCAD
# package, so its readme is generated from this file; the two longest sections of
# the vendor's document - what to buy and how the power supply goes together -
# are documents of their own under ./doc/ and linked from here.
docs:
  name: "\U0001F916 reBot Arm B601 RS - Open Source Hardware Specification"
  intro: |
    <p align="center">
      <img src="../../media/RS5_56.png" alt="reBot-DevArm Banner">
    </p>
    <p align="center">
      <strong>
        <a href="./README_zh.md">简体中文</a> &nbsp;|&nbsp;
        <a href="./README.md">English</a> &nbsp;|&nbsp;
        <a href="./README_fr.md">français</a>&nbsp;|&nbsp;
        <a href="./README_es.md">Español</a>
      </strong>
    </p>


    | Date | Version | File Name | Changelog |
    |----------|------|----------|------|
    |  2026-07-09 | v1.0 |  reBot_B601_RS_v1.0_20260625.step  | Initial upload |


    This BOM is for the reBot Arm B601 RS robotic arm, which uses ROBOSTRIDE series motors. The other version, reBot Arm B601 DM, uses DAMIAO motors; [see the BOM here](../reBot_B601_DM/README.md).

    # 📦 File Structure
    *   3D_Printed_Parts/: Step files for all 3D printed parts.
    *   Metal_Parts/: Step files for all CNC machined metal parts.
    *   Purchased_Parts/: Step files for all purchased components.
    *   reBot_B601_RS_v1.0_20260625.step: Full robotic arm assembly file.

    # 🛒[Gets All Parts](https://www.seeedstudio.com/reBot-Arm-B601-RS-Disassembly-Kit-Version-with-Power-Supply-Bundle.html)
    - We offer five kit options:
      - **reBot-Arm-B601-RS-Disassembly-Kit**
      - **reBot-Arm-B601-RS-Assembly-Version**

    ## 📊 Bill of Materials

    > [!WARNING]
    > Declaration: The published BOM does **not** represent the final shipping version from Seeed. This open-source v1.0 is optimized for developers to reproduce at minimal cost, with some non-essential details simplified.
    > The final Seeed production version will include metal laser engraving for foolproofing, some 3D printed parts will be replaced with metal for durability, clearances and machining tolerances will be adjusted for factory variation (balancing precision and cost), and custom wiring (e.g., braided sleeve protection) will be added at extra cost. However, the mechanical structure remains identical.

    **The parts list below is generated from this package.** Every part is declared
    once in [partcad.yaml](./partcad.yaml), the arm is assembled out of those
    declarations in [arm.assy](./arm.assy), and a quantity is nowhere typed in: it is
    how many times the assembly places the part.

    | Document | What it lists |
    |---|---|
    | [arm.md](./arm.md) | the whole arm: every part, with its picture, material, process, tolerance, file and count |
    | [power-supply.md](./power-supply.md) | the power supply enclosure, the same way |
    | [gripper.md](./gripper.md) | the gripper, whose slide is shared with the B601 DM arm |
    | [doc/buying.md](./doc/buying.md) | the reference prices and the links to the offers |
    | [doc/power-supply-assembly.md](./doc/power-supply-assembly.md) | the power supply assembly steps |

    Seven of this arm's parts are the DM arm's parts - the same solids, published
    under different file names - so they are declared once, there, and aliased here.
    The gripper slide is a sub-assembly of the DM package for the same reason. See
    [PARTCAD.md](../../PARTCAD.md).

    ### 🧩 Printing Recommendations
    - Layer height: 0.2 mm
    - Nozzle: 0.4 mm
    - Supports: Add as needed
    - Materials: High-temperature and load-bearing parts use ABS with 30–80% infill; may also use nylon or carbon-fiber reinforced materials. Cosmetic parts use PLA with 15% infill.

    ### 🧩 Machining Specifications
    - Key dimension tolerance: ±0.02 mm GB/T1840-M
    - Surface finish: Anodizing / Sandblasting
    - Mating parts recommended: H7 / interference fit

    **Four of these plates have generated machining routes.** They are declared as
    machine jobs as well as parts, and
    `pc cam -p -P //pub/robotics/rebot/devarm/b601-rs -O routes` writes the G-code.
    Only four, because most of this arm's metal is not plate: the joint discs are
    turned, the rotators are cut from bar, and a 2.5D outline route is not what makes
    any of them. See [PARTCAD.md](../../PARTCAD.md) and the comment in `partcad.yaml`.

    Most of this arm's machined parts are not plate: the joint discs are turned, the
    rotators are cut from bar. Four of them are, and those four carry the machine
    they are cut on and produce a route (`pc cam`); the rest say `subtractive` and
    nothing more, because a 2.5D outline route is not what makes them.
  usage: |
    ```shell
    pc --no-ansi list parts -P //pub/robotics/rebot/devarm/b601-rs
    pc --no-ansi bom -P //pub/robotics/rebot/devarm/b601-rs arm
    pc --no-ansi inspect -a -P //pub/robotics/rebot/devarm/b601-rs arm
    pc --no-ansi supply quote //pub/robotics/rebot/devarm/b601-rs:arm
    ```

# Who supplies the parts of this package: the two providers the root package
# declares. 'suppliers:' is not inherited from a parent package, so each package
# whose parts are meant to be bought or made names them for itself.
suppliers:
  //pub/robotics/rebot/devarm:reference-prices:
  //pub/robotics/rebot/devarm:workshop:

parts:
  ##############################################################################
  # 3D printed parts
  ##############################################################################
  base-plate:
    type: step
    path: 3D_Printed_Parts/1-BASE-PLATE.step
    desc: Robotic arm base platform (x1); 0.4 mm nozzle, 0.2 mm layer height, 30% infill
    manufacturing:
      method: additive
    tolerance: 0.2
    properties:
      material: //pub/std/manufacturing/material/plastic:abs
      color: "#1A1A1A"

  base-link:
    type: step
    path: 3D_Printed_Parts/1-RSM1-STATOR-1.step
    desc: Robotic arm base link (x1); 0.4 mm nozzle, 0.2 mm layer height, 30% infill
    manufacturing:
      method: additive
    tolerance: 0.2
    properties:
      material: //pub/std/manufacturing/material/plastic:abs
      color: "#1A1A1A"

  upper-arm-filler-l:
    type: step
    path: 3D_Printed_Parts/1-DOWN-DL.step
    desc: Upper arm left filler (x1); 0.4 mm nozzle, 0.2 mm layer height, 15% infill
    manufacturing:
      method: additive
    tolerance: 0.2
    properties:
      material: //pub/std/manufacturing/material/plastic:pla

  upper-arm-filler-r:
    type: step
    path: 3D_Printed_Parts/1-DOWN-DR.step
    desc: Upper arm right filler (x1); 0.4 mm nozzle, 0.2 mm layer height, 15% infill
    manufacturing:
      method: additive
    tolerance: 0.2
    properties:
      material: //pub/std/manufacturing/material/plastic:pla

  arm-filler-m:
    type: step
    path: 3D_Printed_Parts/1-SPACE-UP.step
    desc: Upper and lower arm center filler (x2); 0.4 mm nozzle, 0.2 mm layer height, 30% infill
    manufacturing:
      method: additive
    tolerance: 0.2
    properties:
      material: //pub/std/manufacturing/material/plastic:abs
      color: "#1A1A1A"

  arm-handle:
    type: step
    path: 3D_Printed_Parts/1-HANDLE.step
    desc: Arm handle (x1); 0.4 mm nozzle, 0.2 mm layer height, 30% infill
    manufacturing:
      method: additive
    tolerance: 0.2
    properties:
      material: //pub/std/manufacturing/material/plastic:abs
      color: "#1A1A1A"

  arm-cover:
    type: step
    path: 3D_Printed_Parts/1-COVER.step
    desc: Upper and lower arm cover (x2); 0.4 mm nozzle, 0.2 mm layer height, 15% infill
    manufacturing:
      method: additive
    tolerance: 0.2
    properties:
      material: //pub/std/manufacturing/material/plastic:pla
      color: "#2E7D32"

  lower-arm-filler-l:
    type: step
    path: 3D_Printed_Parts/1-UP-DL.step
    desc: Lower arm left filler (x1); 0.4 mm nozzle, 0.2 mm layer height, 15% infill
    manufacturing:
      method: additive
    tolerance: 0.2
    properties:
      material: //pub/std/manufacturing/material/plastic:pla

  lower-arm-filler-r:
    type: step
    path: 3D_Printed_Parts/1-UP-DR.step
    desc: Lower arm right filler (x1); 0.4 mm nozzle, 0.2 mm layer height, 15% infill
    manufacturing:
      method: additive
    tolerance: 0.2
    properties:
      material: //pub/std/manufacturing/material/plastic:pla

  gripper-limit:
    type: step
    path: 3D_Printed_Parts/1-STOPPER-1.step
    desc: Gripper horizontal limit (x1); 0.4 mm nozzle, 0.2 mm layer height, 15% infill
    manufacturing:
      method: additive
    tolerance: 0.2
    properties:
      material: //pub/std/manufacturing/material/plastic:pla
      color: "#2E7D32"

  finger:
    type: step
    path: 3D_Printed_Parts/1-CLIP.step
    desc: Gripper finger (x2) - print from the side of the gripper for strength; 0.4 mm nozzle, 0.2 mm layer height, 45% infill
    manufacturing:
      method: additive
    tolerance: 0.2
    properties:
      material: //pub/std/manufacturing/material/plastic:abs
      color: "#1A1A1A"

  motor1-harness-clip:
    type: step
    path: 3D_Printed_Parts/RS_Motor1_wiring_harness_clip.stp
    desc: Wiring harness clip for the two sides of motor 1 (x2, optional but recommended); 0.4 mm nozzle, 0.2 mm layer height, 30% infill
    manufacturing:
      method: additive
    tolerance: 0.2
    properties:
      material: //pub/std/manufacturing/material/plastic:abs
      color: "#1A1A1A"

  # Power supply enclosure
  psu-front-cover:
    type: step
    path: 3D_Printed_Parts/RS-power-Top Cover.stp
    desc: Power supply front shell (x1); 0.4 mm nozzle, 0.2 mm layer height, 30% infill
    manufacturing:
      method: additive
    tolerance: 0.2
    properties:
      material: //pub/std/manufacturing/material/plastic:pla

  psu-rear-cover:
    type: step
    path: 3D_Printed_Parts/RS-power-Bottom Cover.stp
    desc: Power supply rear shell (x1); 0.4 mm nozzle, 0.2 mm layer height, 30% infill
    manufacturing:
      method: additive
    tolerance: 0.2
    properties:
      material: //pub/std/manufacturing/material/plastic:pla

  psu-front-cover-slider:
    type: step
    path: 3D_Printed_Parts/RS-power-Top Cover-Sliding Cover.stp
    desc: Power supply front shell sliding cover (x1); 0.4 mm nozzle, 0.2 mm layer height, 30% infill
    manufacturing:
      method: additive
    tolerance: 0.2
    properties:
      material: //pub/std/manufacturing/material/plastic:pla

  ##############################################################################
  # CNC machined metal parts
  #
  # Machining specification (README.md): key dimension tolerance +/-0.02 mm
  # (GB/T1840-M), anodized or sandblasted finish, H7 / interference fit.
  #
  # The tolerance is the 'tolerance:' field and the finish and the fit are
  # 'manufacturing.parameters'; the alloy is catalogued in ../../partcad.yaml.
  # See ../reBot_B601_DM/partcad.yaml and PARTCAD.md.
  ##############################################################################

  motor1-bearing-mount-blank:
    type: build123d
    path: src/stock_plate.py
    desc: The 5052 plate motor1-bearing-mount is cut from
    # 'manufacturable: false' because nobody is asked to make a blank - it is the
    # piece the part above is cut out of, declared so that the cut can be checked,
    # and what a shop actually buys is a sheet with several of these nested on it.
    #
    # 0.8.127 procures a made part's stock, so 'pc test' asks who supplies this,
    # and the flag is what answers: a blank passes. What this repository cannot
    # answer is who supplies the material - the readme prices all the machined
    # parts at about $250 together, material and machining in one figure, and
    # names no metals supplier. See ../../PARTCAD.md.
    manufacturable: false
    parameters:
      step:
        type: string
        default: Metal_Parts/2-RSM1-ROTOR-1.step
      margin: 5.0
    properties:
      material: //pub/robotics/rebot/devarm:aluminium-5052

  motor1-bearing-mount:
    type: step
    path: Metal_Parts/2-RSM1-ROTOR-1.step
    # NOTE: README.md lists this same file twice, as "Motor 1 Bearing Mount"
    # (x1) and as "Link1 Bottom Metal" (x3). One of the two rows is wrong.
    desc: Motor 1 bearing mount (x1) - see note about the duplicated readme row
    manufacturing:
      method: subtractive
      source: motor1-bearing-mount-blank
      desc: Anodized or sandblasted, H7 or interference fit on mating features
    tolerance: 0.02
    properties:
      material: //pub/robotics/rebot/devarm:aluminium-5052

  link1-metal-l-blank:
    type: build123d
    path: src/stock_plate.py
    desc: The 5052 plate link1-metal-l is cut from
    # 'manufacturable: false' because nobody is asked to make a blank - it is the
    # piece the part above is cut out of, declared so that the cut can be checked,
    # and what a shop actually buys is a sheet with several of these nested on it.
    #
    # 0.8.127 procures a made part's stock, so 'pc test' asks who supplies this,
    # and the flag is what answers: a blank passes. What this repository cannot
    # answer is who supplies the material - the readme prices all the machined
    # parts at about $250 together, material and machining in one figure, and
    # names no metals supplier. See ../../PARTCAD.md.
    manufacturable: false
    parameters:
      step:
        type: string
        default: Metal_Parts/2-RSM-ROTOR-L.step
      margin: 5.0
    properties:
      material: //pub/robotics/rebot/devarm:aluminium-5052

  link1-metal-l:
    type: step
    path: Metal_Parts/2-RSM-ROTOR-L.step
    desc: Link 1 left metal (x1)
    manufacturing:
      method: subtractive
      source: link1-metal-l-blank
      desc: Anodized or sandblasted, H7 or interference fit on mating features
    tolerance: 0.02
    properties:
      material: //pub/robotics/rebot/devarm:aluminium-5052

  link1-metal-r-blank:
    type: build123d
    path: src/stock_plate.py
    desc: The 5052 plate link1-metal-r is cut from
    # 'manufacturable: false' because nobody is asked to make a blank - it is the
    # piece the part above is cut out of, declared so that the cut can be checked,
    # and what a shop actually buys is a sheet with several of these nested on it.
    #
    # 0.8.127 procures a made part's stock, so 'pc test' asks who supplies this,
    # and the flag is what answers: a blank passes. What this repository cannot
    # answer is who supplies the material - the readme prices all the machined
    # parts at about $250 together, material and machining in one figure, and
    # names no metals supplier. See ../../PARTCAD.md.
    manufacturable: false
    parameters:
      step:
        type: string
        default: Metal_Parts/2-RSM-ROTOR-R.step
      margin: 5.0
    properties:
      material: //pub/robotics/rebot/devarm:aluminium-5052

  link1-metal-r:
    type: step
    path: Metal_Parts/2-RSM-ROTOR-R.step
    desc: Link 1 right metal (x4)
    manufacturing:
      method: subtractive
      source: link1-metal-r-blank
      desc: Anodized or sandblasted, H7 or interference fit on mating features
    tolerance: 0.02
    properties:
      material: //pub/robotics/rebot/devarm:aluminium-5052

  joint-disc-blank:
    type: build123d
    path: src/stock_plate.py
    desc: The 5052 plate joint-disc is cut from
    # 'manufacturable: false' because nobody is asked to make a blank - it is the
    # piece the part above is cut out of, declared so that the cut can be checked,
    # and what a shop actually buys is a sheet with several of these nested on it.
    #
    # 0.8.127 procures a made part's stock, so 'pc test' asks who supplies this,
    # and the flag is what answers: a blank passes. What this repository cannot
    # answer is who supplies the material - the readme prices all the machined
    # parts at about $250 together, material and machining in one figure, and
    # names no metals supplier. See ../../PARTCAD.md.
    manufacturable: false
    parameters:
      step:
        type: string
        default: Metal_Parts/2-CD.step
      margin: 5.0
    properties:
      material: //pub/robotics/rebot/devarm:aluminium-5052

  joint-disc:
    type: step
    path: Metal_Parts/2-CD.step
    desc: Joint metal disc (x3) - conceals the screws
    manufacturing:
      method: subtractive
      source: joint-disc-blank
      desc: Anodized or sandblasted, H7 or interference fit on mating features
    tolerance: 0.02
    properties:
      material: //pub/robotics/rebot/devarm:aluminium-5052

  rs06-front-extension-blank:
    type: build123d
    path: src/stock_plate.py
    desc: The 5052 plate rs06-front-extension is cut from
    # 'manufacturable: false' because nobody is asked to make a blank - it is the
    # piece the part above is cut out of, declared so that the cut can be checked,
    # and what a shop actually buys is a sheet with several of these nested on it.
    #
    # 0.8.127 procures a made part's stock, so 'pc test' asks who supplies this,
    # and the flag is what answers: a blank passes. What this repository cannot
    # answer is who supplies the material - the readme prices all the machined
    # parts at about $250 together, material and machining in one figure, and
    # names no metals supplier. See ../../PARTCAD.md.
    manufacturable: false
    parameters:
      step:
        type: string
        default: Metal_Parts/2-RSM2-STATOR-1.step
      margin: 5.0
    properties:
      material: //pub/robotics/rebot/devarm:aluminium-5052

  rs06-front-extension:
    type: step
    path: Metal_Parts/2-RSM2-STATOR-1.step
    desc: RS06 front extension (x2)
    manufacturing:
      method: subtractive
      source: rs06-front-extension-blank
      desc: Anodized or sandblasted, H7 or interference fit on mating features
    tolerance: 0.02
    properties:
      material: //pub/robotics/rebot/devarm:aluminium-5052

  rs06-back-extension-blank:
    type: build123d
    path: src/stock_plate.py
    desc: The 5052 plate rs06-back-extension is cut from
    # 'manufacturable: false' because nobody is asked to make a blank - it is the
    # piece the part above is cut out of, declared so that the cut can be checked,
    # and what a shop actually buys is a sheet with several of these nested on it.
    #
    # 0.8.127 procures a made part's stock, so 'pc test' asks who supplies this,
    # and the flag is what answers: a blank passes. What this repository cannot
    # answer is who supplies the material - the readme prices all the machined
    # parts at about $250 together, material and machining in one figure, and
    # names no metals supplier. See ../../PARTCAD.md.
    manufacturable: false
    parameters:
      step:
        type: string
        default: Metal_Parts/2-RSM2-STATOR-2.step
      margin: 5.0
    properties:
      material: //pub/robotics/rebot/devarm:aluminium-5052

  rs06-back-extension:
    type: step
    path: Metal_Parts/2-RSM2-STATOR-2.step
    desc: RS06 back extension (x2)
    manufacturing:
      method: subtractive
      source: rs06-back-extension-blank
      desc: Anodized or sandblasted, H7 or interference fit on mating features
    tolerance: 0.02
    properties:
      material: //pub/robotics/rebot/devarm:aluminium-5052

  link2-blank:
    type: build123d
    path: src/stock_plate.py
    desc: The 5052 plate link2 is cut from
    # 'manufacturable: false' because nobody is asked to make a blank - it is the
    # piece the part above is cut out of, declared so that the cut can be checked,
    # and what a shop actually buys is a sheet with several of these nested on it.
    #
    # 0.8.127 procures a made part's stock, so 'pc test' asks who supplies this,
    # and the flag is what answers: a blank passes. What this repository cannot
    # answer is who supplies the material - the readme prices all the machined
    # parts at about $250 together, material and machining in one figure, and
    # names no metals supplier. See ../../PARTCAD.md.
    manufacturable: false
    parameters:
      step:
        type: string
        default: Metal_Parts/2-LINK-2_3.step
      margin: 5.0
    properties:
      material: //pub/robotics/rebot/devarm:aluminium-5052

  link2:
    type: step
    path: Metal_Parts/2-LINK-2_3.step
    desc: Link 2 left and right metal (x2)
    manufacturing:
      method: subtractive
      source: link2-blank
      desc: Anodized or sandblasted, H7 or interference fit on mating features
    tolerance: 0.02
    properties:
      material: //pub/robotics/rebot/devarm:aluminium-5052

  upper-limit-l-blank:
    type: build123d
    path: src/stock_plate.py
    desc: The 5052 plate upper-limit-l is cut from
    # 'manufacturable: false' because nobody is asked to make a blank - it is the
    # piece the part above is cut out of, declared so that the cut can be checked,
    # and what a shop actually buys is a sheet with several of these nested on it.
    #
    # 0.8.127 procures a made part's stock, so 'pc test' asks who supplies this,
    # and the flag is what answers: a blank passes. What this repository cannot
    # answer is who supplies the material - the readme prices all the machined
    # parts at about $250 together, material and machining in one figure, and
    # names no metals supplier. See ../../PARTCAD.md.
    manufacturable: false
    parameters:
      step:
        type: string
        default: Metal_Parts/2-Upper-Limit_L.stp
      margin: 5.0
    properties:
      material: //pub/robotics/rebot/devarm:aluminium-5052

  upper-limit-l:
    type: step
    path: Metal_Parts/2-Upper-Limit_L.stp
    desc: Upper limit, left (x1)
    manufacturing:
      method: subtractive
      source: upper-limit-l-blank
      desc: Anodized or sandblasted, H7 or interference fit on mating features
    tolerance: 0.02
    properties:
      material: //pub/robotics/rebot/devarm:aluminium-5052

  upper-limit-r-blank:
    type: build123d
    path: src/stock_plate.py
    desc: The 5052 plate upper-limit-r is cut from
    # 'manufacturable: false' because nobody is asked to make a blank - it is the
    # piece the part above is cut out of, declared so that the cut can be checked,
    # and what a shop actually buys is a sheet with several of these nested on it.
    #
    # 0.8.127 procures a made part's stock, so 'pc test' asks who supplies this,
    # and the flag is what answers: a blank passes. What this repository cannot
    # answer is who supplies the material - the readme prices all the machined
    # parts at about $250 together, material and machining in one figure, and
    # names no metals supplier. See ../../PARTCAD.md.
    manufacturable: false
    parameters:
      step:
        type: string
        default: Metal_Parts/2-Upper-Limit_R.stp
      margin: 5.0
    properties:
      material: //pub/robotics/rebot/devarm:aluminium-5052

  upper-limit-r:
    type: step
    path: Metal_Parts/2-Upper-Limit_R.stp
    desc: Upper limit, right (x1)
    manufacturing:
      method: subtractive
      source: upper-limit-r-blank
      desc: Anodized or sandblasted, H7 or interference fit on mating features
    tolerance: 0.02
    properties:
      material: //pub/robotics/rebot/devarm:aluminium-5052

  lower-upper-link-l-blank:
    type: build123d
    path: src/stock_plate.py
    desc: The 5052 plate lower-upper-link-l is cut from
    # 'manufacturable: false' because nobody is asked to make a blank - it is the
    # piece the part above is cut out of, declared so that the cut can be checked,
    # and what a shop actually buys is a sheet with several of these nested on it.
    #
    # 0.8.127 procures a made part's stock, so 'pc test' asks who supplies this,
    # and the flag is what answers: a blank passes. What this repository cannot
    # answer is who supplies the material - the readme prices all the machined
    # parts at about $250 together, material and machining in one figure, and
    # names no metals supplier. See ../../PARTCAD.md.
    manufacturable: false
    parameters:
      step:
        type: string
        default: Metal_Parts/2-RSM3-ROTATOR-L.step
      margin: 5.0
    properties:
      material: //pub/robotics/rebot/devarm:aluminium-5052

  lower-upper-link-l:
    type: step
    path: Metal_Parts/2-RSM3-ROTATOR-L.step
    desc: Lower and upper link, left (x1)
    manufacturing:
      method: subtractive
      source: lower-upper-link-l-blank
      desc: Anodized or sandblasted, H7 or interference fit on mating features
    tolerance: 0.02
    properties:
      material: //pub/robotics/rebot/devarm:aluminium-5052

  lower-upper-link-r-blank:
    type: build123d
    path: src/stock_plate.py
    desc: The 5052 plate lower-upper-link-r is cut from
    # 'manufacturable: false' because nobody is asked to make a blank - it is the
    # piece the part above is cut out of, declared so that the cut can be checked,
    # and what a shop actually buys is a sheet with several of these nested on it.
    #
    # 0.8.127 procures a made part's stock, so 'pc test' asks who supplies this,
    # and the flag is what answers: a blank passes. What this repository cannot
    # answer is who supplies the material - the readme prices all the machined
    # parts at about $250 together, material and machining in one figure, and
    # names no metals supplier. See ../../PARTCAD.md.
    manufacturable: false
    parameters:
      step:
        type: string
        default: Metal_Parts/2-RSM3-ROTATOR-R.step
      margin: 5.0
    properties:
      material: //pub/robotics/rebot/devarm:aluminium-5052

  lower-upper-link-r:
    type: step
    path: Metal_Parts/2-RSM3-ROTATOR-R.step
    desc: Lower and upper link, right (x1)
    manufacturing:
      method: subtractive
      source: lower-upper-link-r-blank
      desc: Anodized or sandblasted, H7 or interference fit on mating features
    tolerance: 0.02
    properties:
      material: //pub/robotics/rebot/devarm:aluminium-5052

  link3-metal-l-blank:
    type: build123d
    path: src/stock_plate.py
    desc: The 5052 plate link3-metal-l is cut from
    # 'manufacturable: false' because nobody is asked to make a blank - it is the
    # piece the part above is cut out of, declared so that the cut can be checked,
    # and what a shop actually buys is a sheet with several of these nested on it.
    #
    # 0.8.127 procures a made part's stock, so 'pc test' asks who supplies this,
    # and the flag is what answers: a blank passes. What this repository cannot
    # answer is who supplies the material - the readme prices all the machined
    # parts at about $250 together, material and machining in one figure, and
    # names no metals supplier. See ../../PARTCAD.md.
    manufacturable: false
    parameters:
      step:
        type: string
        default: Metal_Parts/2-LINK-3_4-L.step
      margin: 5.0
    properties:
      material: //pub/robotics/rebot/devarm:aluminium-5052

  link3-metal-l:
    type: step
    path: Metal_Parts/2-LINK-3_4-L.step
    desc: Link 3 left metal (x1)
    manufacturing:
      method: subtractive
      source: link3-metal-l-blank
      desc: Anodized or sandblasted, H7 or interference fit on mating features
    tolerance: 0.02
    properties:
      material: //pub/robotics/rebot/devarm:aluminium-5052

  link3-metal-r-blank:
    type: build123d
    path: src/stock_plate.py
    desc: The 5052 plate link3-metal-r is cut from
    # 'manufacturable: false' because nobody is asked to make a blank - it is the
    # piece the part above is cut out of, declared so that the cut can be checked,
    # and what a shop actually buys is a sheet with several of these nested on it.
    #
    # 0.8.127 procures a made part's stock, so 'pc test' asks who supplies this,
    # and the flag is what answers: a blank passes. What this repository cannot
    # answer is who supplies the material - the readme prices all the machined
    # parts at about $250 together, material and machining in one figure, and
    # names no metals supplier. See ../../PARTCAD.md.
    manufacturable: false
    parameters:
      step:
        type: string
        default: Metal_Parts/2-LINK-3_4-R.step
      margin: 5.0
    properties:
      material: //pub/robotics/rebot/devarm:aluminium-5052

  link3-metal-r:
    type: step
    path: Metal_Parts/2-LINK-3_4-R.step
    desc: Link 3 right metal (x1)
    manufacturing:
      method: subtractive
      source: link3-metal-r-blank
      desc: Anodized or sandblasted, H7 or interference fit on mating features
    tolerance: 0.02
    properties:
      material: //pub/robotics/rebot/devarm:aluminium-5052

  link3-connector-blank:
    type: build123d
    path: src/stock_plate.py
    desc: The 5052 plate link3-connector is cut from
    # 'manufacturable: false' because nobody is asked to make a blank - it is the
    # piece the part above is cut out of, declared so that the cut can be checked,
    # and what a shop actually buys is a sheet with several of these nested on it.
    #
    # 0.8.127 procures a made part's stock, so 'pc test' asks who supplies this,
    # and the flag is what answers: a blank passes. What this repository cannot
    # answer is who supplies the material - the readme prices all the machined
    # parts at about $250 together, material and machining in one figure, and
    # names no metals supplier. See ../../PARTCAD.md.
    manufacturable: false
    parameters:
      step:
        type: string
        default: Metal_Parts/2-SPACE-UP-2.step
      margin: 5.0
    properties:
      material: //pub/robotics/rebot/devarm:aluminium-5052

  link3-connector:
    type: step
    path: Metal_Parts/2-SPACE-UP-2.step
    desc: Link 3 right and left link (x1)
    manufacturing:
      method: subtractive
      source: link3-connector-blank
      desc: Anodized or sandblasted, H7 or interference fit on mating features
    tolerance: 0.02
    properties:
      material: //pub/robotics/rebot/devarm:aluminium-5052

  motor-cable-clip-blank:
    type: build123d
    path: src/stock_plate.py
    desc: The 5052 plate motor-cable-clip is cut from
    # 'manufacturable: false' because nobody is asked to make a blank - it is the
    # piece the part above is cut out of, declared so that the cut can be checked,
    # and what a shop actually buys is a sheet with several of these nested on it.
    #
    # 0.8.127 procures a made part's stock, so 'pc test' asks who supplies this,
    # and the flag is what answers: a blank passes. What this repository cannot
    # answer is who supplies the material - the readme prices all the machined
    # parts at about $250 together, material and machining in one figure, and
    # names no metals supplier. See ../../PARTCAD.md.
    manufacturable: false
    parameters:
      step:
        type: string
        default: Metal_Parts/1-O-CLIP.step
      margin: 5.0
    properties:
      material: //pub/robotics/rebot/devarm:aluminium-5052

  motor-cable-clip:
    type: step
    path: Metal_Parts/1-O-CLIP.step
    desc: Motor 4-7 cable fixing (x4) - can be printed in ABS with M2 nuts instead
    manufacturing:
      method: subtractive
      source: motor-cable-clip-blank
      desc: Anodized or sandblasted, H7 or interference fit on mating features
    tolerance: 0.02
    properties:
      material: //pub/robotics/rebot/devarm:aluminium-5052

  motor-back-spacer-blank:
    type: build123d
    path: src/stock_plate.py
    desc: The 5052 plate motor-back-spacer is cut from
    # 'manufacturable: false' because nobody is asked to make a blank - it is the
    # piece the part above is cut out of, declared so that the cut can be checked,
    # and what a shop actually buys is a sheet with several of these nested on it.
    #
    # 0.8.127 procures a made part's stock, so 'pc test' asks who supplies this,
    # and the flag is what answers: a blank passes. What this repository cannot
    # answer is who supplies the material - the readme prices all the machined
    # parts at about $250 together, material and machining in one figure, and
    # names no metals supplier. See ../../PARTCAD.md.
    manufacturable: false
    parameters:
      step:
        type: string
        default: Metal_Parts/2-Motor_Back_Spacer.step
      margin: 5.0
    properties:
      material: //pub/robotics/rebot/devarm:aluminium-5052

  link4-5-l-blank:
    type: build123d
    path: src/stock_plate.py
    desc: The 5052 plate link4-5-l is cut from
    # 'manufacturable: false' because nobody is asked to make a blank - it is the
    # piece the part above is cut out of, declared so that the cut can be checked,
    # and what a shop actually buys is a sheet with several of these nested on it.
    #
    # 0.8.127 procures a made part's stock, so 'pc test' asks who supplies this,
    # and the flag is what answers: a blank passes. What this repository cannot
    # answer is who supplies the material - the readme prices all the machined
    # parts at about $250 together, material and machining in one figure, and
    # names no metals supplier. See ../../PARTCAD.md.
    manufacturable: false
    parameters:
      step:
        type: string
        default: Metal_Parts/2-LINK-4_5-L.step
      margin: 5.0
    properties:
      material: //pub/robotics/rebot/devarm:aluminium-5052

  link4-5-l:
    type: step
    path: Metal_Parts/2-LINK-4_5-L.step
    desc: Link 4-5 left (x1)
    manufacturing:
      method: subtractive
      source: link4-5-l-blank
      desc: Anodized or sandblasted, H7 or interference fit on mating features
    tolerance: 0.02
    properties:
      material: //pub/robotics/rebot/devarm:aluminium-5052

  link4-5-r-blank:
    type: build123d
    path: src/stock_plate.py
    desc: The 5052 plate link4-5-r is cut from
    # 'manufacturable: false' because nobody is asked to make a blank - it is the
    # piece the part above is cut out of, declared so that the cut can be checked,
    # and what a shop actually buys is a sheet with several of these nested on it.
    #
    # 0.8.127 procures a made part's stock, so 'pc test' asks who supplies this,
    # and the flag is what answers: a blank passes. What this repository cannot
    # answer is who supplies the material - the readme prices all the machined
    # parts at about $250 together, material and machining in one figure, and
    # names no metals supplier. See ../../PARTCAD.md.
    manufacturable: false
    parameters:
      step:
        type: string
        default: Metal_Parts/2-LINK-4_5-R.step
      margin: 5.0
    properties:
      material: //pub/robotics/rebot/devarm:aluminium-5052

  link4-5-r:
    type: step
    path: Metal_Parts/2-LINK-4_5-R.step
    desc: Link 4-5 right (x1)
    manufacturing:
      method: subtractive
      source: link4-5-r-blank
      desc: Anodized or sandblasted, H7 or interference fit on mating features
    tolerance: 0.02
    properties:
      material: //pub/robotics/rebot/devarm:aluminium-5052

  link5-blank:
    type: build123d
    path: src/stock_plate.py
    desc: The 5052 plate link5 is cut from
    # 'manufacturable: false' because nobody is asked to make a blank - it is the
    # piece the part above is cut out of, declared so that the cut can be checked,
    # and what a shop actually buys is a sheet with several of these nested on it.
    #
    # 0.8.127 procures a made part's stock, so 'pc test' asks who supplies this,
    # and the flag is what answers: a blank passes. What this repository cannot
    # answer is who supplies the material - the readme prices all the machined
    # parts at about $250 together, material and machining in one figure, and
    # names no metals supplier. See ../../PARTCAD.md.
    manufacturable: false
    parameters:
      step:
        type: string
        default: Metal_Parts/2-RSM5-STATOR.step
      margin: 5.0
    properties:
      material: //pub/robotics/rebot/devarm:aluminium-5052

  link5:
    type: step
    path: Metal_Parts/2-RSM5-STATOR.step
    desc: Link 5 (x1)
    manufacturing:
      method: subtractive
      source: link5-blank
      desc: Anodized or sandblasted, H7 or interference fit on mating features
    tolerance: 0.02
    properties:
      material: //pub/robotics/rebot/devarm:aluminium-5052

  wrist-connector-a-blank:
    type: build123d
    path: src/stock_plate.py
    desc: The 5052 plate wrist-connector-a is cut from
    # 'manufacturable: false' because nobody is asked to make a blank - it is the
    # piece the part above is cut out of, declared so that the cut can be checked,
    # and what a shop actually buys is a sheet with several of these nested on it.
    #
    # 0.8.127 procures a made part's stock, so 'pc test' asks who supplies this,
    # and the flag is what answers: a blank passes. What this repository cannot
    # answer is who supplies the material - the readme prices all the machined
    # parts at about $250 together, material and machining in one figure, and
    # names no metals supplier. See ../../PARTCAD.md.
    manufacturable: false
    parameters:
      step:
        type: string
        default: Metal_Parts/2-RSM6-RORATOR-1.step
      margin: 5.0
    properties:
      material: //pub/robotics/rebot/devarm:aluminium-5052

  wrist-connector-a:
    type: step
    path: Metal_Parts/2-RSM6-RORATOR-1.step
    desc: Wrist connector A (x1)
    manufacturing:
      method: subtractive
      source: wrist-connector-a-blank
      desc: Anodized or sandblasted, H7 or interference fit on mating features
    tolerance: 0.02
    properties:
      material: //pub/robotics/rebot/devarm:aluminium-5052

  wrist-connector-b-blank:
    type: build123d
    path: src/stock_plate.py
    desc: The 5052 plate wrist-connector-b is cut from
    # 'manufacturable: false' because nobody is asked to make a blank - it is the
    # piece the part above is cut out of, declared so that the cut can be checked,
    # and what a shop actually buys is a sheet with several of these nested on it.
    #
    # 0.8.127 procures a made part's stock, so 'pc test' asks who supplies this,
    # and the flag is what answers: a blank passes. What this repository cannot
    # answer is who supplies the material - the readme prices all the machined
    # parts at about $250 together, material and machining in one figure, and
    # names no metals supplier. See ../../PARTCAD.md.
    manufacturable: false
    parameters:
      step:
        type: string
        default: Metal_Parts/2-RSM6-RORATOR-2.step
      margin: 5.0
    properties:
      material: //pub/robotics/rebot/devarm:aluminium-5052

  wrist-connector-b:
    type: step
    path: Metal_Parts/2-RSM6-RORATOR-2.step
    desc: Wrist connector B (x1)
    manufacturing:
      method: subtractive
      source: wrist-connector-b-blank
      desc: Anodized or sandblasted, H7 or interference fit on mating features
    tolerance: 0.02
    properties:
      material: //pub/robotics/rebot/devarm:aluminium-5052

  gripper-connector-a-blank:
    type: build123d
    path: src/stock_plate.py
    desc: The 5052 plate gripper-connector-a is cut from
    # 'manufacturable: false' because nobody is asked to make a blank - it is the
    # piece the part above is cut out of, declared so that the cut can be checked,
    # and what a shop actually buys is a sheet with several of these nested on it.
    #
    # 0.8.127 procures a made part's stock, so 'pc test' asks who supplies this,
    # and the flag is what answers: a blank passes. What this repository cannot
    # answer is who supplies the material - the readme prices all the machined
    # parts at about $250 together, material and machining in one figure, and
    # names no metals supplier. See ../../PARTCAD.md.
    manufacturable: false
    parameters:
      step:
        type: string
        default: Metal_Parts/2-M6-ROTOR.step
      margin: 5.0
    properties:
      material: //pub/robotics/rebot/devarm:aluminium-5052

  # TODO(data): README.md lists "Gripper Connector B" as 2-M7-STATOR.step, which
  # is not in the repository. 2-M7-ROTOR.step is, and is not listed. Confirm
  # which file is the right one before declaring the part:
  # gripper-connector-b:
  #   type: step
  #   path: Metal_Parts/2-M7-ROTOR.step
  #   desc: Gripper connector B (x1)

  slider-bracket-blank:
    type: build123d
    path: src/stock_plate.py
    desc: The 5052 plate slider-bracket is cut from
    # 'manufacturable: false' because nobody is asked to make a blank - it is the
    # piece the part above is cut out of, declared so that the cut can be checked,
    # and what a shop actually buys is a sheet with several of these nested on it.
    #
    # 0.8.127 procures a made part's stock, so 'pc test' asks who supplies this,
    # and the flag is what answers: a blank passes. What this repository cannot
    # answer is who supplies the material - the readme prices all the machined
    # parts at about $250 together, material and machining in one figure, and
    # names no metals supplier. See ../../PARTCAD.md.
    manufacturable: false
    parameters:
      step:
        type: string
        default: Metal_Parts/2-RAIL-BASE-1.step
      margin: 5.0
    properties:
      material: //pub/robotics/rebot/devarm:aluminium-5052

  slider-extension-blank:
    type: build123d
    path: src/stock_plate.py
    desc: The 5052 plate slider-extension is cut from
    # 'manufacturable: false' because nobody is asked to make a blank - it is the
    # piece the part above is cut out of, declared so that the cut can be checked,
    # and what a shop actually buys is a sheet with several of these nested on it.
    #
    # 0.8.127 procures a made part's stock, so 'pc test' asks who supplies this,
    # and the flag is what answers: a blank passes. What this repository cannot
    # answer is who supplies the material - the readme prices all the machined
    # parts at about $250 together, material and machining in one figure, and
    # names no metals supplier. See ../../PARTCAD.md.
    manufacturable: false
    parameters:
      step:
        type: string
        default: Metal_Parts/2-SLIDER-FIX.step
      margin: 5.0
    properties:
      material: //pub/robotics/rebot/devarm:aluminium-5052

  rack-blank:
    type: build123d
    path: src/stock_plate.py
    desc: The 5052 plate rack is cut from
    # 'manufacturable: false' because nobody is asked to make a blank - it is the
    # piece the part above is cut out of, declared so that the cut can be checked,
    # and what a shop actually buys is a sheet with several of these nested on it.
    #
    # 0.8.127 procures a made part's stock, so 'pc test' asks who supplies this,
    # and the flag is what answers: a blank passes. What this repository cannot
    # answer is who supplies the material - the readme prices all the machined
    # parts at about $250 together, material and machining in one figure, and
    # names no metals supplier. See ../../PARTCAD.md.
    manufacturable: false
    parameters:
      step:
        type: string
        default: Metal_Parts/2-RACK-1M.step
      margin: 5.0
    properties:
      material: //pub/robotics/rebot/devarm:aluminium-5052

  # Two parts that are in Metal_Parts/ and in no BOM table of README.md, so until
  # the released assembly was read they had no quantity and no role. It says where
  # each one is and how many there are: the plate is one, in the base, and the
  # spacer is one, in link 3. What neither the readme nor the CAD says is the
  # machining tolerance, which the machined parts above state as 0.02 - so these
  # two state it as well, being the same kind of part cut the same way.
  base-motor-plate-blank:
    type: build123d
    path: src/stock_plate.py
    desc: The 5052 plate base-motor-plate is cut from
    # See the other blanks above for what this flag is here to answer.
    manufacturable: false
    parameters:
      step:
        type: string
        default: Metal_Parts/2-RSM1-STATOR-2.step
      margin: 5.0
    properties:
      material: //pub/robotics/rebot/devarm:aluminium-5052

  base-motor-plate:
    type: step
    path: Metal_Parts/2-RSM1-STATOR-2.step
    desc: Base motor mounting plate (x1) - 95 x 95 x 8 mm, under the RS06 of joint 1
    manufacturing:
      method: subtractive
      source: base-motor-plate-blank
      desc: Anodized or sandblasted, H7 or interference fit on mating features
    tolerance: 0.02
    properties:
      material: //pub/robotics/rebot/devarm:aluminium-5052

  motor4-stator-spacer-blank:
    type: build123d
    path: src/stock_plate.py
    desc: The 5052 plate motor4-stator-spacer is cut from
    # See the other blanks above for what this flag is here to answer.
    manufacturable: false
    parameters:
      step:
        type: string
        default: Metal_Parts/2-SPACE-M4-STATOR.step
      margin: 5.0
    properties:
      material: //pub/robotics/rebot/devarm:aluminium-5052

  motor4-stator-spacer:
    type: step
    path: Metal_Parts/2-SPACE-M4-STATOR.step
    desc: Motor 4 stator spacer (x1) - 63 mm across, 5.5 mm thick, in link 3
    manufacturing:
      method: subtractive
      source: motor4-stator-spacer-blank
      desc: Anodized or sandblasted, H7 or interference fit on mating features
    tolerance: 0.02
    properties:
      material: //pub/robotics/rebot/devarm:aluminium-5052

  ##############################################################################
  # Shared with the DM arm
  #
  # These are not "similar to" the DM arm's parts: they are the same solids. The
  # vendor publishes a copy of each in both releases under its own file name, and
  # the two copies agree vertex for vertex once aligned - which is how they were
  # found, by comparing every STEP file of one arm against every STEP file of the
  # other (see ../../PARTCAD.md, "What the two arms share").
  #
  # So each is declared once, in the DM package, and aliased here: one part, one
  # blank, one route, one line in a shop's quote for both arms - and a difference
  # that shows up in a future release is a difference somebody has to look at
  # rather than two files quietly drifting apart.
  #
  # The RS release's own copies are still in ./Metal_Parts and
  # ./3D_Printed_Parts; the file each alias stands in for is named beside it.
  ##############################################################################
  rail-bracket:
    type: alias
    source: //pub/robotics/rebot/devarm/b601-dm:rail-bracket
    desc: "Gripper slider support bracket (x1) - RS copy: 1-RAIL-BASE-2.step"

  motor-back-spacer:
    type: alias
    source: //pub/robotics/rebot/devarm/b601-dm:motor-back-spacer
    desc: "Motor 4 back cable spacer (x1) - RS copy: 2-Motor_Back_Spacer.step"

  rack:
    type: alias
    source: //pub/robotics/rebot/devarm/b601-dm:rack
    desc: "Rack (x2) - RS copy: 2-RACK-1M.step"

  slider-bracket:
    type: alias
    source: //pub/robotics/rebot/devarm/b601-dm:slider-bracket
    desc: "Gripper slider metal bracket (x1) - RS copy: 2-RAIL-BASE-1.step"

  slider-extension:
    type: alias
    source: //pub/robotics/rebot/devarm/b601-dm:slider-extension
    desc: "Slider to gripper extension (x2) - RS copy: 2-SLIDER-FIX.step"

  gripper-connector-a:
    type: alias
    source: //pub/robotics/rebot/devarm/b601-dm:gripper-connector-a
    desc: "Gripper connector A (x1) - RS copy: 2-M6-ROTOR.step"

  # The seventh, and the answer to a question README.md left open: it lists
  # "2-M7-STATOR.step" for gripper connector B, and this repository has no such
  # file. It has 2-M7-ROTOR.step, which is the DM arm's gear connector, vertex
  # for vertex. So that is what this part is.
  gear-connector:
    type: alias
    source: //pub/robotics/rebot/devarm/b601-dm:gear-connector
    desc: "The boss the gripper pinion sits on (x1) - RS copy: 2-M7-ROTOR.step, which README.md calls 2-M7-STATOR.step and lists as \"gripper connector B\""

  ##############################################################################
  # Purchased parts - fasteners
  #
  # See ../reBot_B601_DM/partcad.yaml for the naming shorthand (HM/KM/KA) and
  # for the open question about the drive type of the KM* screws.
  ##############################################################################
  screw-hm3-6:
    type: alias
    source: //pub/robotics/rebot/devarm/third_party:screw/hm3x6
    desc: M3x6 hex socket head cap screw (x8+)

  screw-hm3-8:
    type: alias
    source: //pub/robotics/rebot/devarm/third_party:screw/hm3x8
    desc: M3x8 hex socket head cap screw (x45 in the released CAD; README.md says 60+)

  screw-hm3-26:
    type: alias
    source: //pub/robotics/rebot/devarm/third_party:screw/hm3x25
    desc: M3x26 hex socket head cap screw (x6+ per README.md; the released CAD holds none - see ../../PARTCAD.md)

  screw-hm3-30:
    type: alias
    source: //pub/robotics/rebot/devarm/third_party:screw/hm3x30
    desc: M3x30 hex socket head cap screw (x8 in the released CAD; README.md says 16+)

  screw-hm4-8:
    type: alias
    source: //pub/robotics/rebot/devarm/third_party:screw/hm4x8
    desc: M4x8 hex socket head screw (x6 in the released CAD) - README.md calls it a set screw

  screw-hm4-16:
    type: alias
    source: //pub/robotics/rebot/devarm/third_party:screw/hm4x16
    desc: M4x16 hex socket head screw (x18 in the released CAD) - README.md calls it a set screw

  screw-hm4-70:
    type: alias
    source: //pub/robotics/rebot/devarm/third_party:screw/hm4x70
    desc: M4x70 hex socket head screw (x4 in the released CAD) - README.md calls it a set screw

  screw-km3-7:
    type: alias
    source: //pub/robotics/rebot/devarm/third_party:screw/km3x7
    desc: M3x7 countersunk head screw (x58 in the released CAD; README.md says 80+)

  screw-km3-16:
    type: enrich
    source: //pub/std/metric/cqwarehouse:fastener/countersunk-iso10642
    desc: M3x16 countersunk head screw (x8+ per README.md; the released CAD holds none - see ../../PARTCAD.md)
    vendor: amazon
    sku: B01E6EIC2S
    with:
      size: M3-0.5
      length: 16

  # Power supply enclosure fasteners (README.md, "Consumables BOM")
  screw-m4x6-countersunk:
    type: enrich
    source: //pub/std/metric/cqwarehouse:fastener/countersunk-iso7046
    desc: M4x6 304 stainless steel Phillips countersunk head screw (x10)
    with:
      size: M4-0.7
      length: 6

  screw-m3x8-countersunk:
    type: enrich
    source: //pub/std/metric/cqwarehouse:fastener/countersunk-iso7046
    desc: M3x8 304 stainless steel Phillips countersunk head screw (x2)
    with:
      size: M3-0.5
      length: 8

  screw-m3x8-pan:
    type: enrich
    source: //pub/std/metric/cqwarehouse:fastener/raisedcheesehead-iso7045
    desc: M3x8 304 stainless steel Phillips pan head screw (x2)
    with:
      size: M3-0.5
      length: 8

  ##############################################################################
  # Purchased parts - the vendor publishes no CAD model
  #
  # Envelopes from //pub/robotics/rebot/devarm/third_party, aliased here under the
  # names the readme uses. See ../reBot_B601_DM/partcad.yaml for the same block on
  # the DM side, and each envelope's 'summary' for what it is not.
  ##############################################################################
  # NOTE: no 'vendor'/'sku' here. An alias reads them from the part it points at,
  # which is where they are declared; declaring them on the alias itself has no
  # effect at all (a PartCAD bug - see PARTCAD.md), so writing them twice would
  # only be a second copy to keep in step.
  actuator-rs00:
    type: alias
    source: //pub/robotics/rebot/devarm/third_party:actuator/rs00
    desc: Brushless actuator RobStride RS00 (x4)

  actuator-rs06:
    type: alias
    source: //pub/robotics/rebot/devarm/third_party:actuator/rs06
    desc: Brushless actuator RobStride RS06 (x3)

  bearing-6803zz:
    type: alias
    source: //pub/robotics/rebot/devarm/third_party:bearing/f6803zz
    desc: Bearing 6803ZZ (x2 in the released CAD; README.md says 3)

  bearing-axk5578:
    type: alias
    source: //pub/robotics/rebot/devarm/third_party:bearing/axk5578
    desc: Thrust bearing AXK5578 (x1)

  rail-mgn9-170:
    type: alias
    source: //pub/robotics/rebot/devarm/third_party:rail/mgn9-170
    desc: Linear rail MGN9-170mm (x1, gripper)

  carriage-mgn9:
    type: alias
    source: //pub/robotics/rebot/devarm/third_party:carriage/mgn9c
    desc: Slider block MGN9 (x2, gripper)

  pad-silicone:
    type: alias
    source: //pub/robotics/rebot/devarm/third_party:pad/silicone-30x9x2
    desc: Silicone pad 30x9x2mm (x1 per the readme; the released CAD has four)

  psu-lrs-600-48:
    type: alias
    source: //pub/robotics/rebot/devarm/third_party:psu/lrs-600-48
    desc: Power supply MeanWell LRS-600-48, 48V 12.5A (x1)

  connector-xt60e:
    type: alias
    source: //pub/robotics/rebot/devarm/third_party:connector/xt60e-female
    desc: Output port XT60E female + lug pigtail (x1)

  # The two parts the RS release holds that nobody publishes a model of, taken out
  # of the released DM assembly - which holds the same screw and the same gear -
  # rather than approximated. See ../../third_party/partcad.yaml, "Not envelopes".
  screw-ka3-12:
    type: alias
    source: //pub/robotics/rebot/devarm/third_party:screw/ka3x12
    desc: KA3x12 self-tapping screw (x34 in the released CAD; README.md says 48+)

  gear-m1-16t:
    type: alias
    source: //pub/robotics/rebot/devarm/third_party:gear/m1-16t-b6
    desc: Module 1, 16 tooth, 6 mm bore gear - what drives the two gripper racks (x1)

  # The motor harness connector. The harnesses themselves are assemblies - a
  # length of wire and two of these - and the released assembly places the
  # connector bodies, twelve of them on the motors and two on the base panel.
  connector-xt30:
    type: alias
    source: //pub/robotics/rebot/devarm/third_party:connector/xt30-2x2-plug
    desc: XT30 2+2 connector body, the motor end of a harness (x12 in the released CAD)

  connector-xt30-socket:
    type: alias
    source: //pub/robotics/rebot/devarm/third_party:connector/xt30-2x2-socket
    desc: XT30 2+2 panel socket, the base end of a harness (x2 in the released CAD)

  # Still without a shape, and so still out of the BOM:
  #
  #   Hex nut                  M3x2.5                                      x2
  #   CAN-USB driver board                                                 x1
  #   XT30 2+2 power separation board                                      x1
  #   3-in-1 IEC inlet socket  quick-connect, red switch, dual nuts        x1
  #   Power cord               US standard AC cable                        x1
  #   Power AC wiring          1.5mm^2 red/blue/yellow, 10cm               x3
  #   Adapter cable            XT30U female to XT60 male                   x1
  #
  # The XT30 2+2 harnesses (320 mm x1+, 200 mm x4+, 300 mm x1+, straight x1+) are
  # assemblies rather than parts - see 'cable/xt30-2x2-350' in the third_party
  # package for the pattern.
  ##############################################################################

# What the shop cuts these plates on, once, for every part that declares a
# 'cam:' section of its own. The numbers are a 3-axis router in 5052 aluminium
# with flood coolant: conservative feeds, a shallow pass, and climb milling for
# the edge finish the readme's anodized parts need. A part that needs something
# else says so for itself.
#
# 'pc cam' writes the route of every such part; 'pc test' runs the same code as
# its 'cam' check and fails a part whose section cannot produce one. That is what
# makes the "subtractive" method above a claim somebody checked rather than a
# label: a tool that will not fit the inside corners of a part is a route that
# does not come out.
# A projection of every object, next to the package. The generated bills of
# materials show each line's picture from these, which is the column a reader of
# a parts list looks at first; SVG so that a diff is a diff and the files stay
# small.
render:
  svg:
    prefix: doc/

  # The package document. README.md is the default name and the name this
  # folder's readme already has, so nothing has to be said about it - the DM
  # package says 'path: README.md' only because its own copy is spelt in lower
  # case.
  readme:

cam:
  gcode:
    feed: 900 mm/min
    plunge: 250 mm/min
    depth_per_pass: 0.8 mm
    safe_z: 5 mm
    speed: 12000 rpm
    direction: climb

assemblies:
  # The same parts as the DM arm's gripper for the most part - the racks, the
  # slider bracket, the two extensions, the gear connector, the rail, its two
  # carriages and the gear are aliased from that package rather than declared
  # again - but its own assembly rather than a shared one. Measured from the
  # slider bracket, the two releases agree on every one of these parts in X and
  # differ in Z: this arm's carriages are at +/-14.8 mm against the DM arm's
  # +/-14.3, its racks at +/-4.125 against +/-4.175. One sub-assembly holding both
  # would be wrong for one of them. See ../reBot_B601_DM/partcad.yaml and
  # ../../PARTCAD.md.
  gripper:
    type: assy
    path: gripper.assy
    desc: The B601 RS gripper as the released assembly holds it (22 of its 23 components; 2-M7-STATOR.step is not published)
    manufacturable: true
    render:
      readme:

  arm:
    type: assy
    desc: reBot Arm B601 RS (structure only so far - see ../../PARTCAD.md)
    manufacturable: true
    # The bill of materials as markdown, so a change to it is a diff.
    render:
      readme:

  power-supply:
    type: assy
    desc: Power supply enclosure, assembled per README.md "Power Supply Assembly"
    manufacturable: true
    # The bill of materials as markdown, so a change to it is a diff.
    render:
      readme:

  # There is no 'reference/arm' object any more, and the released STEP file it
  # declared is read by ../../tools/assy_from_reference.py instead.
  #
  # PartCAD cannot read reBot_B601_RS_v1.0_20260625.step usefully. As
  # 'type: step' it flattens to solids named '<component>_solid<n>', which is why
  # the placements were never recovered from it that way - and it does not finish:
  # 'pc render' of that object decomposes 296 of the file's 326 components into
  # temporary STEP files and then stalls, on the same component every time, with
  # the daemon idle and nothing said. See ../../PARTCAD.md.
  #
  # The generator reads the same file through OpenCASCADE's XCAF layer in about a
  # minute, with every name and every transformation intact, which is where both
  # this package's assemblies come from.
