clairbee/rebot-devarm/(commit log)

2026-08-14 Add PartCAD package for the BOM and assembly instructions
    Declare the robot as a PartCAD package so that the bill of materials and
    the assembly instructions are machine-readable instead of living only in
    the readme tables.
    * partcad.yaml: root package, depends on the public PartCAD index and on
    the two variant packages.
    * hardware/reBot_B601_{DM,RS}/partcad.yaml: every 3D printed and CNC
    machined part of the readme BOM, pointing at the STEP file in this
    repository, plus the standard fasteners as enriched cq-warehouse parts.
    * hardware/reBot_B601_DM/arm.assy: all 55 manufactured parts placed with
    the quantities of the readme (locations still to be recovered from the
    released STEP).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
2026-09-02 Update the PartCAD package for 0.8.33
    PartCAD 0.8.x landed most of what the first round was blocked on, so the
    package now uses it and the notes say what is left.
    * Materials move from 'parameters' to 'properties': 'material' is an
    object-type parameter now, accepted only on the homogeneous part types,
    and a 'step' part that declares one fails to load. Print settings,
    machining tolerance and finish go to 'requirements' for the same
    reason - see PARTCAD.md.
    * CNC parts declare 'manufacturing: {method: subtractive}', which is
    valid in both the schema and the loader as of 0.8.
    * Assemblies drop 'manufacturing: {method: basic}' - implied by the
    'assy' type - and declare 'manufactura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
    [partcad.yaml]
2026-09-14 Give the purchased parts shapes, and verify the geometry
    The parts the arm buys had no shape, so they were out of the assembly and
    out of the BOM. They have one now, and for the first time PartCAD builds
    the geometry of this repository rather than only parsing its
    configuration - the proxy-aware connectivity probe of 0.8.x is what
    unlocked that.
    * third_party/: envelope shapes for the actuators, bearings, linear rail
    and carriage, power supplies, XT30/XT60 connectors, wire and silicone
    pad - 15 parts, all building, each saying in its 'summary' which of its
    dimensions are stated and which are inferred. The variants alias them,
    so 'pc bom' for the DM arm is 71 line items rather than 5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
2026-09-16 Replace the readme BOM tables with generated parts lists
    The three hand-written BOM tables in each variant's readme - printed parts,
    machined parts, purchased parts - are what this package existed to replace, and
    until now it could not: a generated parts list had a name, a count and a
    description where the hand-written one had a picture, a file, a material and a
    process note per row. PartCAD 0.8.91 and the columns added to it alongside this
    commit close that gap, so the tables are gone and the readmes point at
    'arm.md' and 'power-supply.md' beside each assembly.
    What that took on this side:
    * Every part now declares what a shop is told. 'manufacturing.parameters' holds
    the nozzle, layer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
    [partcad.yaml]
2026-09-25 Assemble both arms where their designers put them
    Both releases are STEP files with the product structure intact - every component
    carries the name of the file that part is published as and the transformation
    that places it - and until now this repository read them as anonymous solids and
    placed every part at the identity location. tools/assy_from_reference.py reads
    that structure through OpenCASCADE's XCAF layer and transcribes it, so the two
    arms are now the arms their designers assembled: all 326 components of the DM
    arm and 262 of the RS arm's 263, the one left out being a solid the RS release
    holds and does not publish as a part.
    It is checked rather than assumed, at three levels. Ever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
    [price_list.csv]
2026-09-25 Record what pc test says about an arm that is in the right place
    1850 failures over the tree: 994 interference, 728 connectivity, 62 cam, 22
    manufacturability. It is the first run with real placements in it - over an
    assembly at the identity location the geometric checks had nothing to measure -
    so the numbers are new rather than worse, and PARTCAD.md now reads them one group
    at a time.
    Two of them are worth knowing without reading the file. Three quarters of the
    interference findings are a fastener against the thing it fastens, which is how
    the released assembly models a screw in a tapped hole and is the point rather
    than a clash; separating those from real ones needs the joints declared.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
2026-10-02 Give the actuators the vendor's geometry, and audit the release against itself
    Rebased on PartCAD 0.8.136, which fixes four things this repository had reported
    and changes one it has to answer for.
    THE 74 MB
    The four actuators were the one shortcut in the last round: kept as cylinders in
    the vendor's frame rather than taken out of the released assembly, because their
    models are 17 to 25 MB each. 'pc test' charged for it immediately - a cylinder of
    the full diameter swallows the steps a real motor has, so two DM4310s overlapped
    each other by 30534 mm^3, and the largest interference findings in the repository
    measured the shortcut rather than the arm.
    '//pub/electronics/sbcs/intel' is how t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
    [partcad.yaml]
2026-10-02 Regenerate every document against the actuators, and correct two findings
    The actuators became the vendor's own solids in the last commit, which promised
    the generated documents would follow. They do, and so does what `pc test` says
    about the tree.
    What the actuator geometry bought, measured over a cleared test cache:
    | | before | after |
    |---|---|---|
    | failures | 1850 | 1586 |
    | interference | 994 | 731 |
    | of them involving an actuator | 291 | 141 |
    | largest structure-against-structure finding outside the power supply | 30534 mm^3, two DM4310s | 662 mm^3, a flange against link 3's bracket |
    The five largest interference findings are now all in the power supply
    enclosure, which is the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
    [partcad.yaml]
